badgeteam/hackerhotel2027-hardware/design/ai/all_tentacles_check.html

# all 5 tentacles — reconstructed LED chains

Re-extracted by detecting red pixels directly in a fresh high-resolution render of starfish_silkscreen.svg, instead of parsing path geometry — the previous pass mis-measured two circles on arm_right because your edit had merged some paths into multi-part shapes, which inflated their computed centers. Pixel detection sidesteps that.

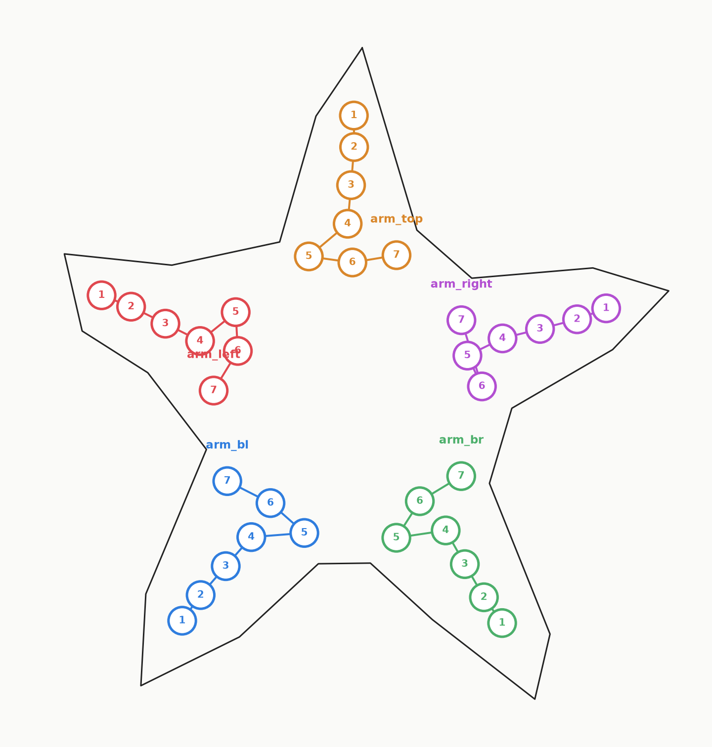
[picture p1: design/ai/all_tentacles_check.png]
Starfish outline with all 5 tentacle LED chains numbered tip to body


- arm_right (purple) — #1 and #3 now resolve correctly; the chain runs a clean 1→5 line down the arm instead of jumping around.
- arm_left, arm_br, arm_top — #5/#6 swapped as requested.
- arm_bl — re-confirmed against your original approval (this data source changed slightly, needed the same #5/#6 swap again).

If this looks right, next step is moving the matrix off-board and placing all 35 tentacle LEDs (plus rotating each to follow its local chain direction) via the IPC API.
