badgeteam/hackerhotel2027-hardware/design/ai/flank_leds_check.html

# 8 flanking 0402s per tentacle, RGB chain unmoved

For each of the 7 RGB positions, found the nearest small (unhighlighted) silkscreen dot to its left and right (perpendicular to the local chain direction), then kept the best 8 per arm — so coverage spreads across most of the 7 positions rather than clustering at one spot. All matches land within 8 mm of their RGB neighbor; most under 4 mm.

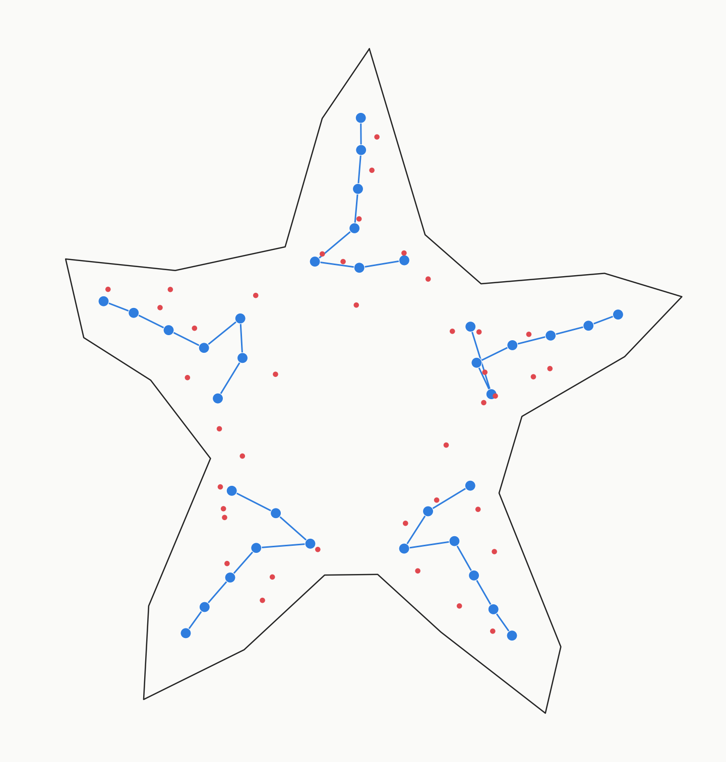
[picture p2: design/ai/flank_leds_check.png]
All 5 tentacles with the confirmed RGB LED chain in blue and 8 flanking single-color 0402 LEDs in red snapped to nearby silkscreen dots


RGB chain (unmoved) flanking 0402, snapped to an existing silkscreen dot

- Distribution isn't perfectly symmetric L/R or across all 7 positions — it follows wherever the existing artwork actually has a nearby dot, since the pattern itself isn't perfectly even arm-to-arm.
- arm_left leans mostly to one side (the artwork has fewer dots on its other side near the chain) — worth a glance if you want it more balanced.
- None of the 40 flank LEDs reuse a silkscreen dot already claimed by another flank or by the RGB chain.

If this looks right, next step is pushing all 40 (8×5) flank LEDs plus the 235-LED ring matrix to the live board via the IPC API, alongside the unmoved RGB tentacle chains.
