badgeteam/hackerhotel2027-hardware/design/ai/matrix_rings_check.html

# center matrix — dartboard spokes, 9 rings, 279 LEDs

Single LED at the center, then 9 rings at a constant 2.2 mm radial step. Spoke count starts at 6 and doubles whenever tangential spacing would otherwise exceed ≈1.4× the target pitch — each doubling reuses the existing spoke angles and interleaves new ones, so 6 spokes run perfectly straight from center to rim, with more forking in further out. Lands on 279 with only the outermost ring trimmed (48→44, ≈8%).

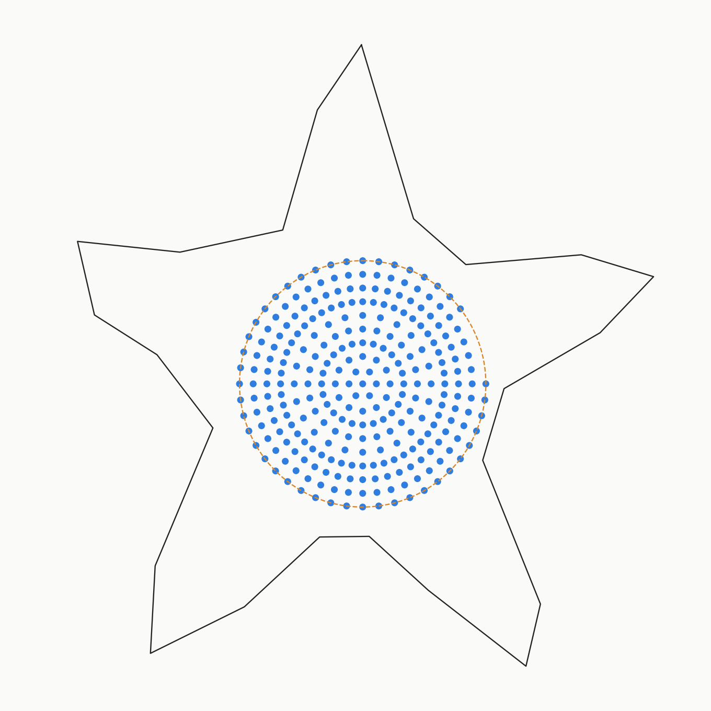
[picture p3: design/ai/matrix_rings_check.png]
Starfish outline with a dartboard-style spoke LED matrix filling the central cavity


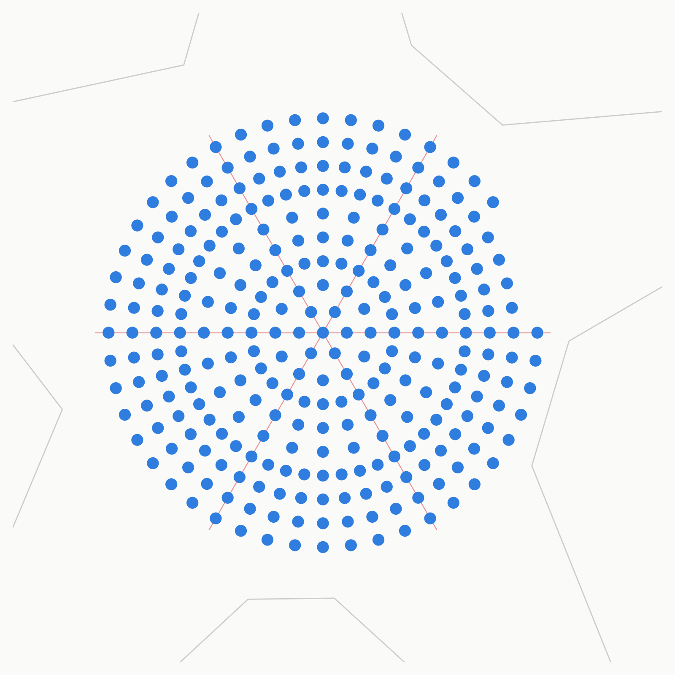
[picture p4: design/ai/spoke_zoom_check.png]
Zoomed view with the 6 primary spokes highlighted in red, confirming they run straight from center to edge through LED centers


Zoomed check: red lines are the 6 unbroken spokes, overlaid to confirm alignment — they pass exactly through LED centers at every ring.

ring | radius (mm) | spokes | arc pitch (mm)
center | 0 | 1 | —
1 | 2.2 | 6 | 2.304
2 | 4.4 | 12 | 2.304
3 | 6.6 | 24 | 1.728
4 | 8.8 | 24 | 2.304
5 | 11.0 | 24 | 2.880
6 | 13.2 | 48 | 1.728
7 | 15.4 | 48 | 2.016
8 | 17.6 | 48 | 2.304
9 | 19.8 | 44 (trimmed from 48) | 2.592

- 6 spokes run unbroken from center to rim; 6 more join at ring 3, 24 more at ring 6 — all stay radially aligned with the originals.
- Arc pitch ranges 1.73–2.88 mm — a bit less even than the pure-ring version, the tradeoff for spoke alignment.
- Four-layer board handles inner-ring trace escape through vias without issue.
- Scrolling text/graphics mapping (ring/spoke → pixel) is a firmware concern, happy to sanity-check once layout is settled.
