badgeteam/hackerhotel2027-hardware/design/ai/tentacle_check.html

# tentacle 1 — LED chain order, reconstructed from your markup

Matched each red mark to the nearest silkscreen dot by rendering the SVG's coordinate space and solving for the pixel→mm transform (residuals <0.2 mm on 6 of 7 points). Chain order below runs tip→body, inferred from vertical position in the image.

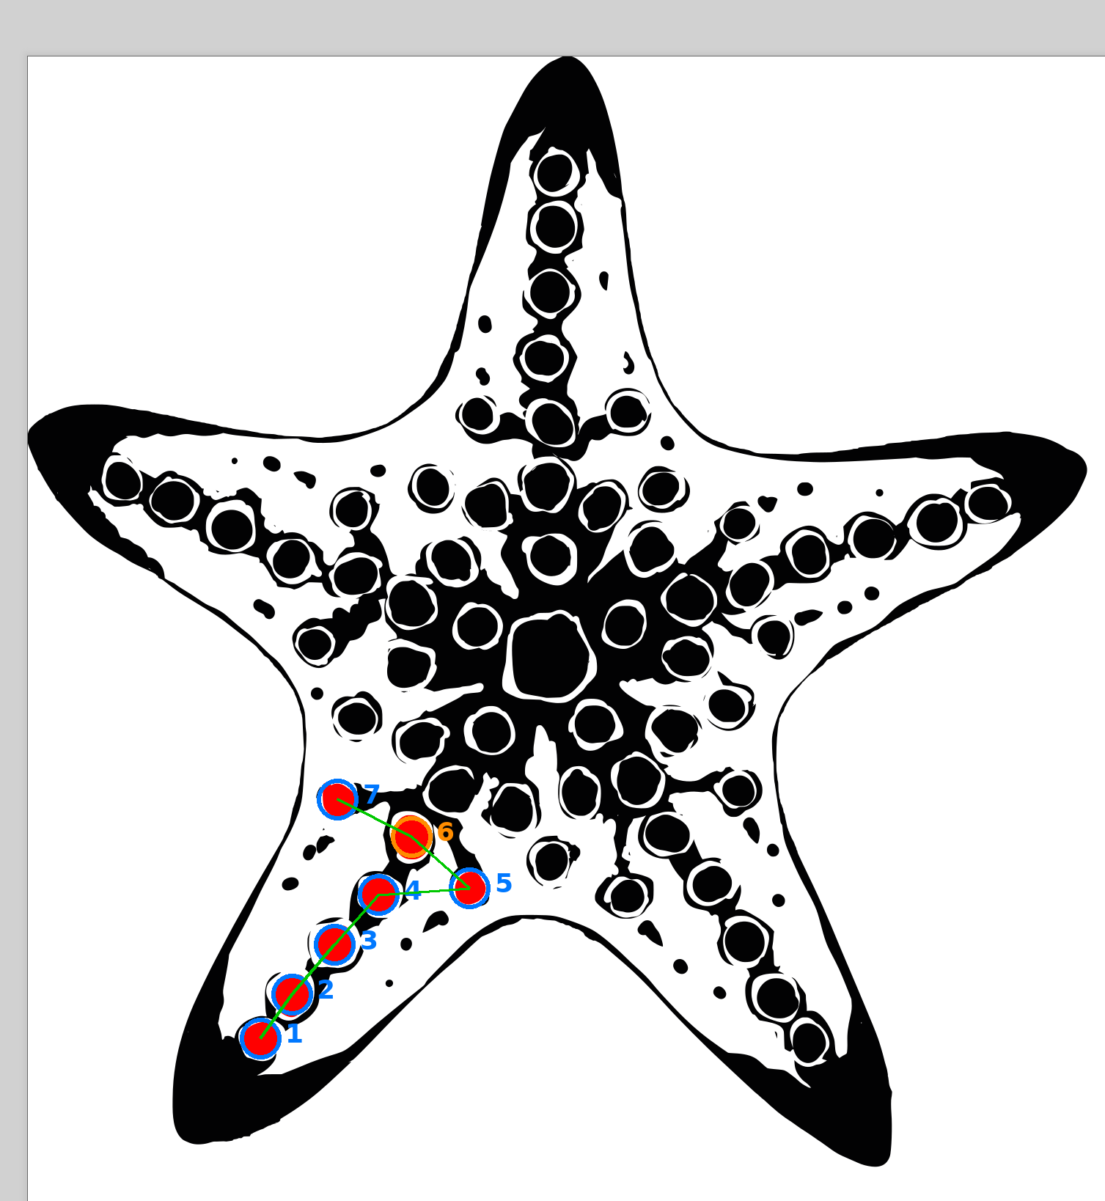
[picture p5: design/ai/tentacle_order_check.png]
Starfish silkscreen with red-highlighted tentacle LED positions, overlaid with numbered order markers


matched to an existing silkscreen dot no dot here — gap in the texture, position interpolated

# | x (mm) | y (mm) | source

1 | 79.05 | 242.64 | silkscreen dot
2 | 86.67 | 232.45 | silkscreen dot
3 | 96.70 | 220.56 | silkscreen dot
4 | 106.77 | 208.92 | silkscreen dot
5 | 128.28 | 207.26 | silkscreen dot
6 | 114.71 | 195.16 | no dot — interpolated
7 | 97.53 | 186.27 | silkscreen dot

Two things to confirm before I replicate this onto the other 4 arms: is tip→body (1→7) the order you want wired, and for #6, should the LED sit at the interpolated point shown, or snap to a nearby real dot instead?
