badgeteam/hackerhotel2027-hardware/design/ai/crop_arm_right.png

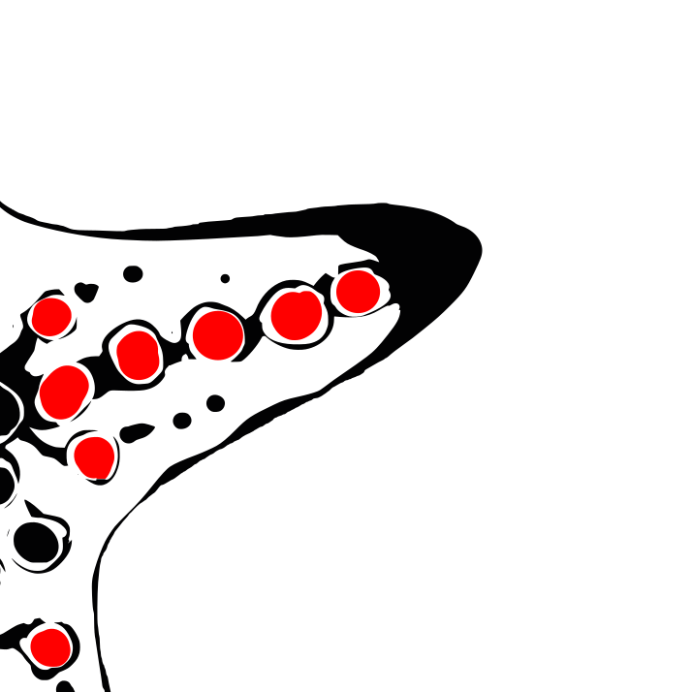
design/ai/crop_arm_right.png
