badgeteam/hackerhotel2027-hardware/design/ai/flow_matrix_check.png

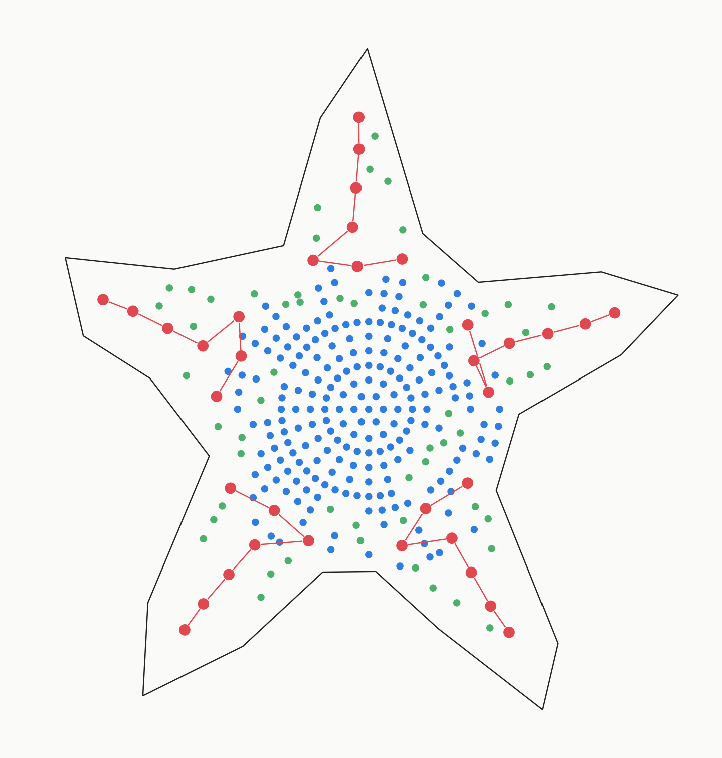
design/ai/flow_matrix_check.png
