badgeteam/hackerhotel2027-hardware/design/ai/grid_final_check.png

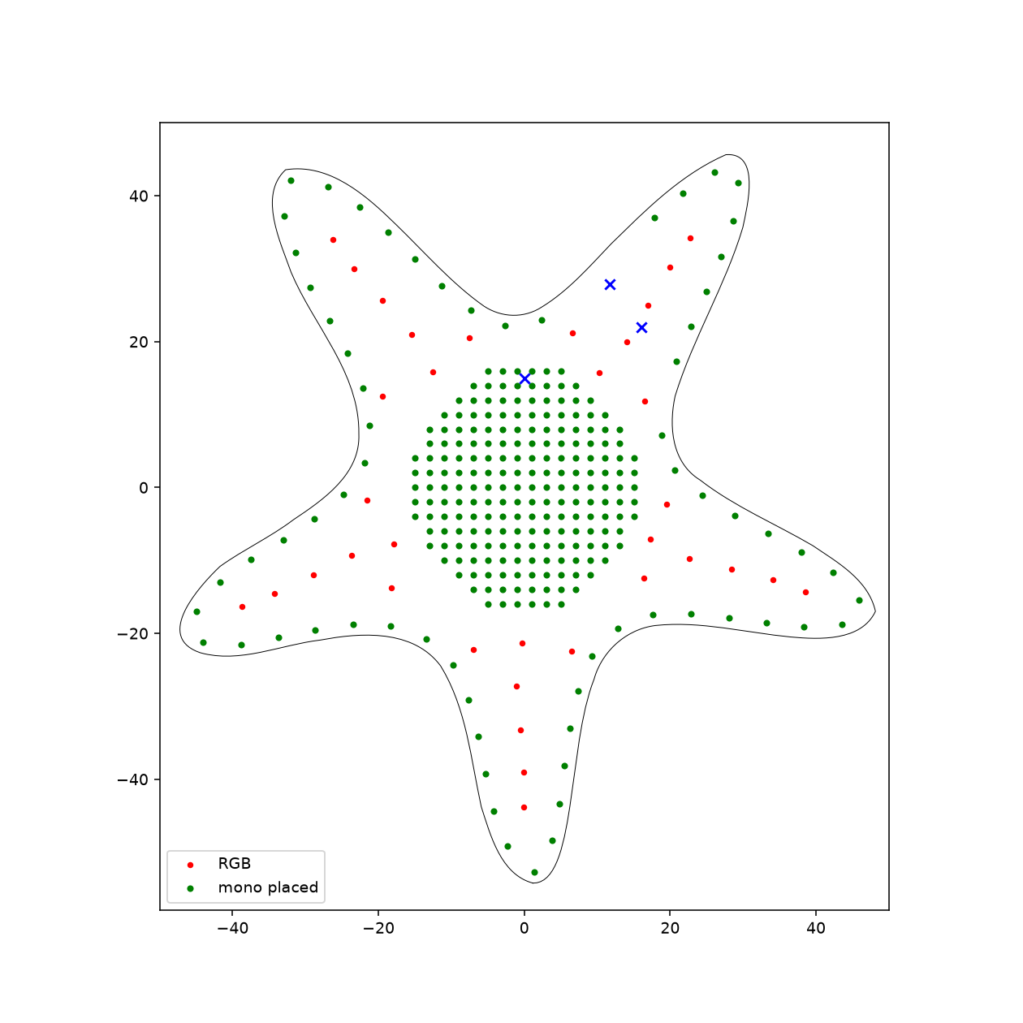
design/ai/grid_final_check.png
