badgeteam/hackerhotel2027-hardware/design/ai/grid_matrix_new_check.png

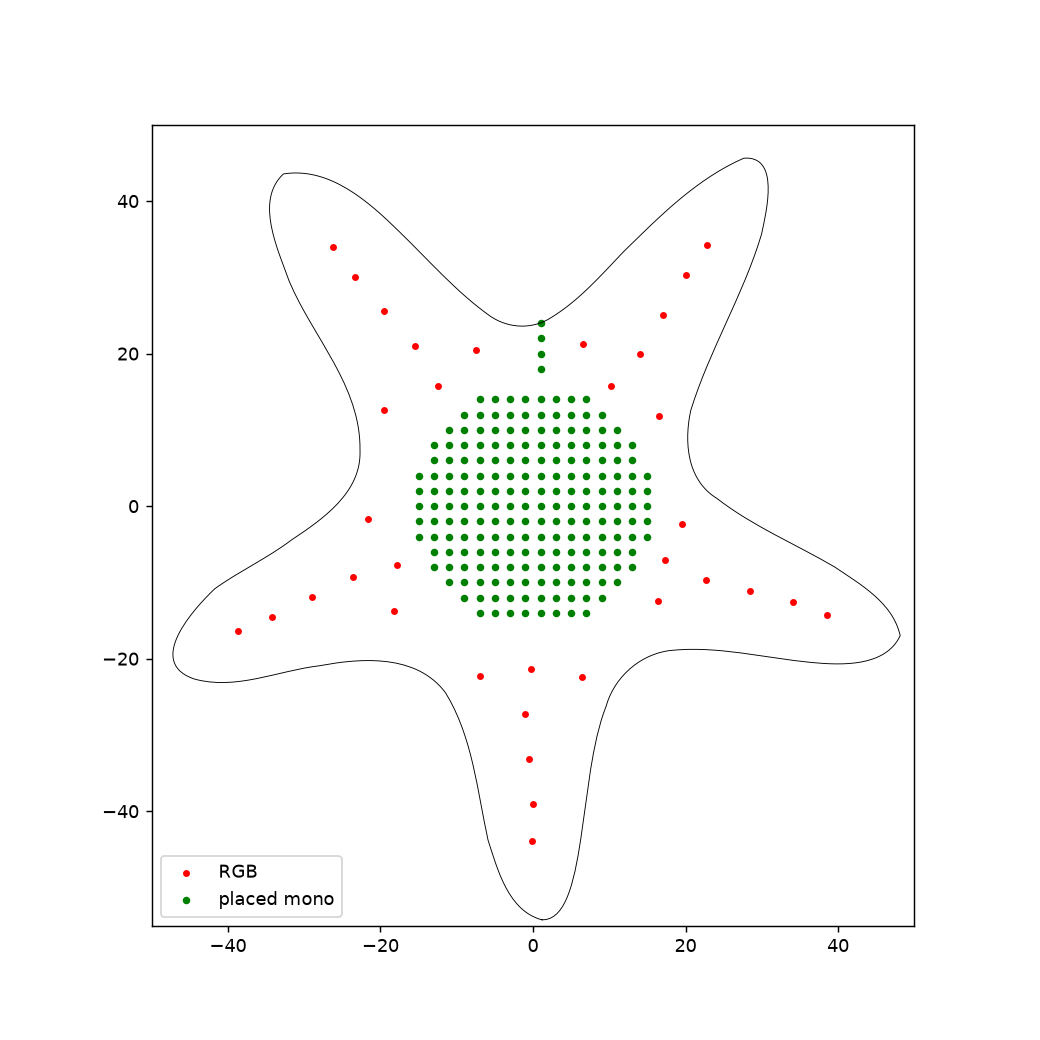
design/ai/grid_matrix_new_check.png
