badgeteam/hackerhotel2027-hardware/design/ai/silk_full.png

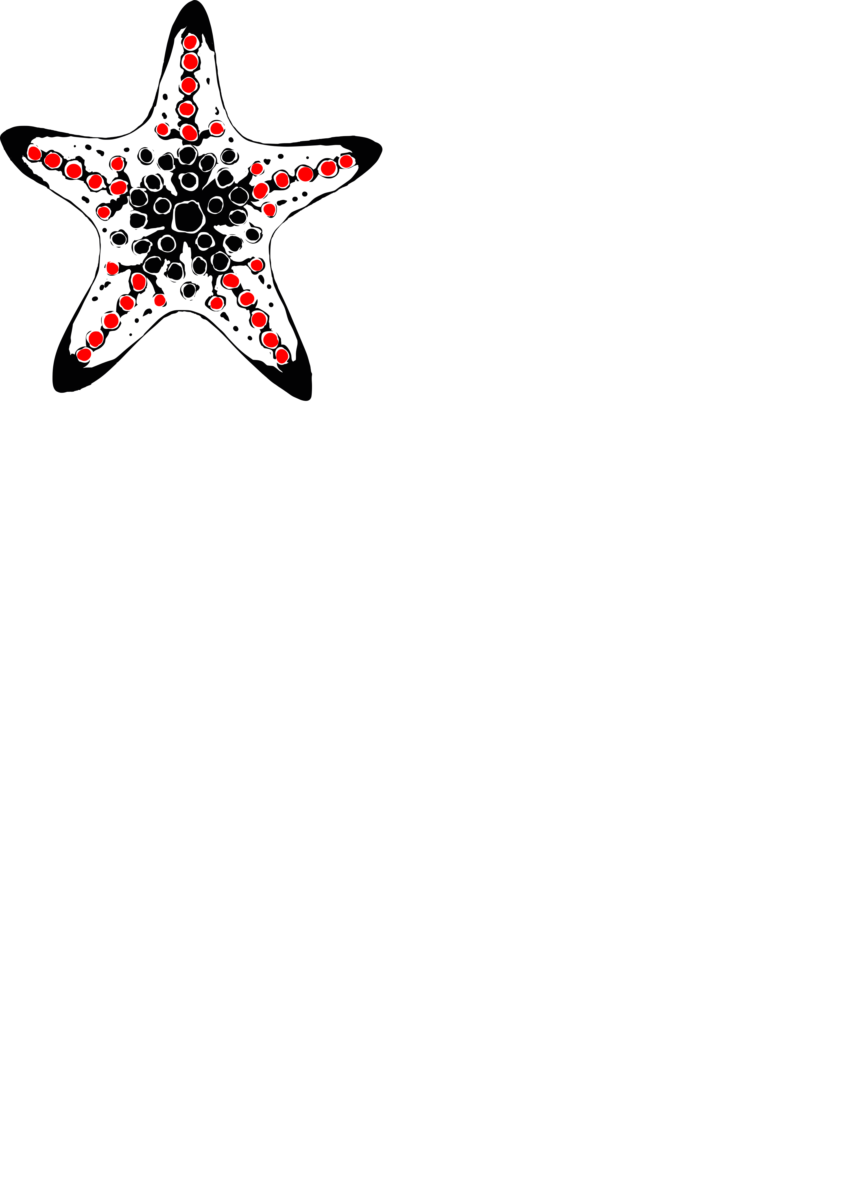
design/ai/silk_full.png
