badgeteam/hackerhotel2027-hardware/production/bom.csv

Designator | Footprint | Quantity | Value | LCSC Part #
C1, C3, C7 | 0603 | 3 | 10u | C19702
C2 | 0402 | 1 | 100n | C1525
C4, C5 | 0402 | 2 | 100n | C307331
C8 | 0603 | 1 | 1u | C5199872
D1, D10, D100, D101, D102, D103, D104, D105, D106, D107, D108, D109, D11, D110, D111, D112, D113, D114, D115, D116, D117, D118, D119, D12, D120, D121, D122, D123, D124, D125, D126, D127, D128, D129, D13, D130, D131, D132, D133, D134, D135, D136, D137, D138, D139, D14, D140, D141, D142, D143, D144, D145, D146, D147, D148, D149, D15, D150, D158, D159, D16, D160, D161, D162, D163, D164, D165, D166, D167, D168, D169, D17, D170, D171, D172, D173, D174, D175, D176, D177, D178, D179, D18, D180, D181, D182, D183, D184, D185, D186, D187, D188, D189, D19, D190, D191, D192, D193, D194, D195, D196, D197, D198, D199, D2, D20, D200, D201, D202, D203, D204, D205, D206, D207, D208, D21, D216, D217, D218, D219, D22, D220, D221, D222, D223, D224, D225, D226, D227, D228, D229, D23, D230, D231, D232, D233, D234, D235, D236, D237, D238, D239, D24, D240, D241, D242, D243, D244, D245, D246, D247, D248, D249, D25, D250, D251, D252, D253, D254, D255, D256, D257, D258, D259, D26, D260, D261, D262, D263, D264, D265, D266, D27, D274, D275, D276, D277, D278, D279, D28, D280, D281, D282, D283, D284, D285, D286, D287, D288, D289, D29, D290, D291, D292, D293, D294, D295, D296, D297, D298 | 0402 | 200 | LED | C52675968
D151, D152, D153, D154, D155, D156, D157, D209, D210, D211, D212, D213, D214, D215, D267, D268, D269, D270, D271, D272, D273, D35, D36, D37, D38, D39, D40, D41, D93, D94, D95, D96, D97, D98, D99 | LED-SMD-4P-L1.6-W1.5_NH-B1515RGBA-GF | 35 | NH-B1515RGBA-GF | C52212029
D299, D3, D30, D300, D301, D302, D303, D304, D305, D306, D307, D308, D309, D31, D310, D311, D312, D313, D314, D32, D33, D34, D4, D42, D43, D44, D45, D46, D47, D48, D49, D5, D50, D51, D52, D53, D54, D55, D56, D57, D58, D59, D6, D60, D61, D62, D63, D64, D65, D66, D67, D68, D69, D7, D70, D71, D72, D73, D74, D75, D76, D77, D78, D79, D8, D80, D81, D82, D83, D84, D85, D86, D87, D88, D89, D9, D90, D91, D92 | 0402 | 79 | LED | C52675968
D315 | 0603 | 1 | IR LED | C965886
D316 | D_SOD-323 | 1 | 1N5819WS | C191023
J1 | USB_C_Receptacle_HRO_TYPE-C-31-M-12 | 1 | USB device | C165948
J2 | CONN-SMD_PH-2AWB | 1 | Battery | C20598817
Q1 | SOT-23 | 1 | JSM2301S | C916399
R1, R10, R11, R12, R13, R14, R15, R16, R17, R18, R19, R2, R20, R21, R22, R23, R24, R3, R32, R4, R5, R6, R7, R8, R9 | 0402 | 25 | 200 | C25087
R25, R26, R27, R29, R30, R34, R36 | 0402 | 7 | 10k | C25744
R28 | 0402 | 1 | 47 | C22369545
R31, R33 | 0402 | 2 | 5k1 | C25905
R35 | 0402 | 1 | 2k | C4109
R37 | 0402 | 1 | 100k | C25741
S1 | OPTO-SMD_4P-L3.9-W3.4_IRM-H432M3-R8 | 1 | DY-IRMHF384-T05-2.5KB | C7280961
SW1, SW2, SW3, SW4 | SW-SMD_4P-L5.1-W5.1-P3.70-LS6.5-TL_H1.5 | 4 | TS-1187A-B-A-B | C318884
U1 | LQFP-64_L7.0-W7.0-P0.40-LS9.2-BL | 1 | CH643Q | C22448687
U2 | USON-10_L2.5-W1.0-P0.50-BL | 1 | TPD4E05U06DQAR | C138714
U3 | SOT-23-5 | 1 | XT4054K421MR-G | C141405
