badgeteam/hackerhotel2027-hardware/hackerhotel2027.kicad_pcb

## KiCad design hackerhotel2027.kicad_pcb (2026-10-26)

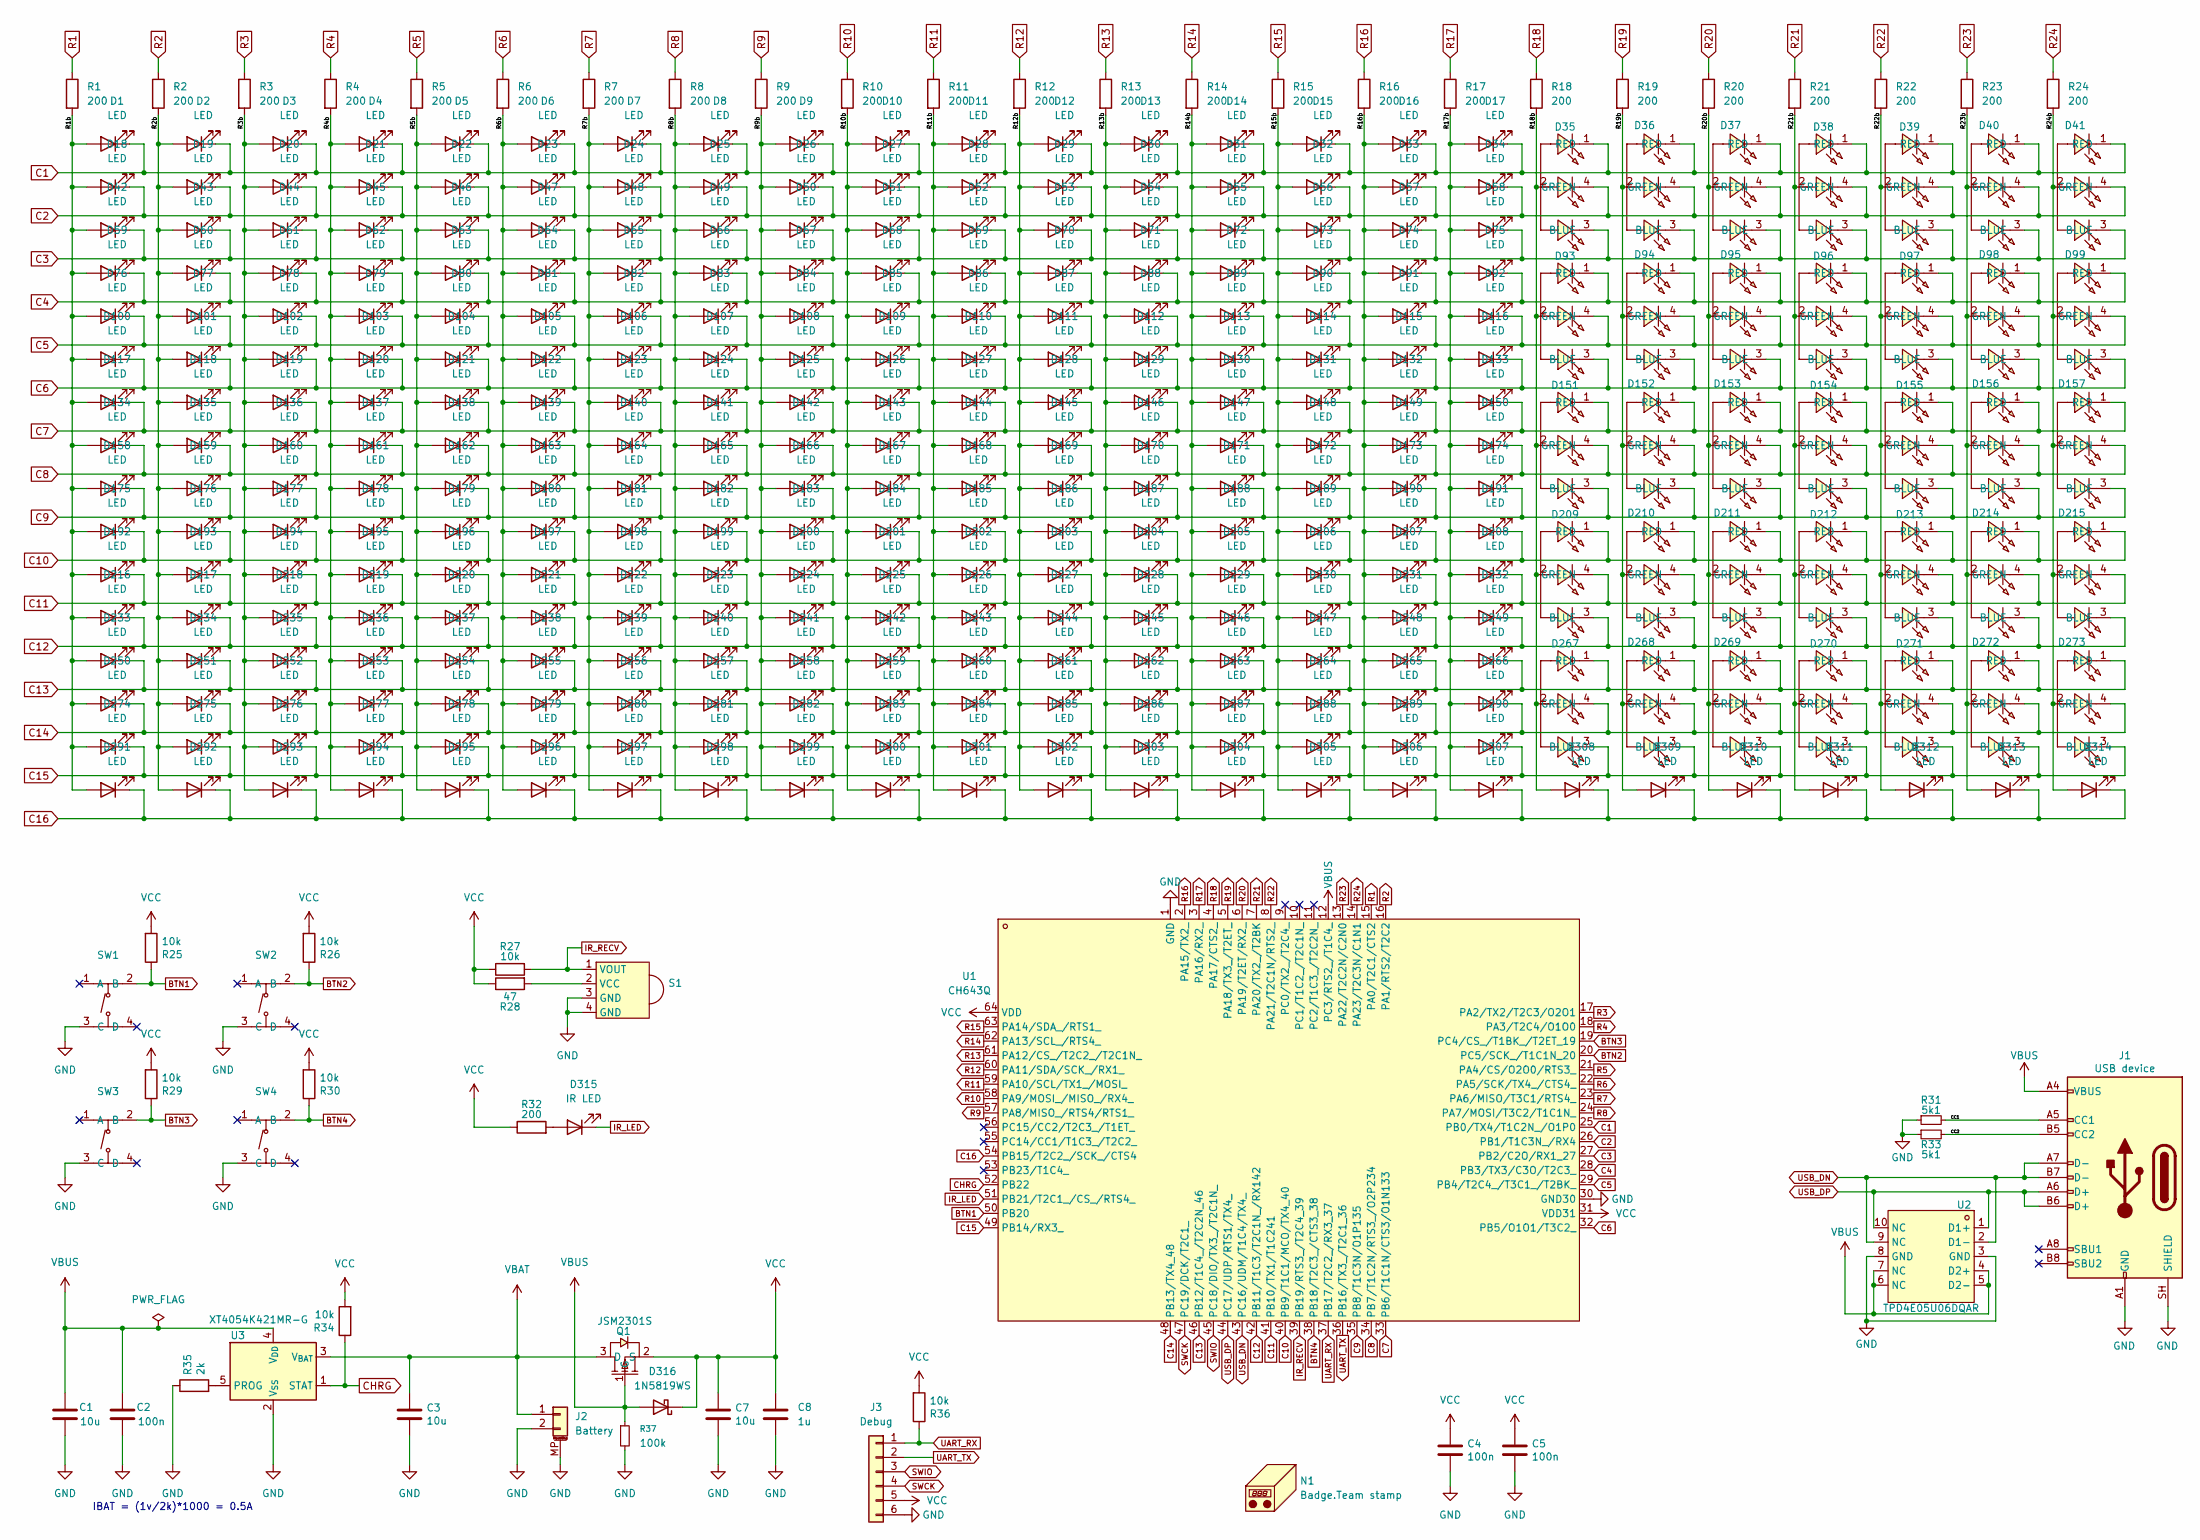
[picture p11: schematic hackerhotel2027.kicad_sch, Hackerhotel 2027 badge]

Parts:
C1, C3, C7: 10u; C_0603_1608Metric; LCSC Part C19702
C2: 100n; C_0402_1005Metric; LCSC Part C1525
C4, C5: 100n; C_0402_1005Metric; LCSC Part C307331
C8: 1u; C_0603_1608Metric; LCSC Part C5199872
D1, D2, D3, D4, D5, D6, D7, D8, D9, D10, D11, D12, D13, D14, D15, D16, D17, D18, D19, D20, D21, D22, D23, D24, D25, D26, D27, D28, D29, D30, D31, D32, D33, D34, D42, D43, D44, D45, D46, D47, D48, D49, D50, D51, D52, D53, D54, D55, D56, D57, D58, D59, D60, D61, D62, D63, D64, D65, D66, D67, D68, D69, D70, D71, D72, D73, D74, D75, D76, D77, D78, D79, D80, D81, D82, D83, D84, D85, D86, D87, D88, D89, D90, D91, D92, D100, D101, D102, D103, D104, D105, D106, D107, D108, D109, D110, D111, D112, D113, D114, D115, D116, D117, D118, D119, D120, D121, D122, D123, D124, D125, D126, D127, D128, D129, D130, D131, D132, D133, D134, D135, D136, D137, D138, D139, D140, D141, D142, D143, D144, D145, D146, D147, D148, D149, D150, D158, D159, D160, D161, D162, D163, D164, D165, D166, D167, D168, D169, D170, D171, D172, D173, D174, D175, D176, D177, D178, D179, D180, D181, D182, D183, D184, D185, D186, D187, D188, D189, D190, D191, D192, D193, D194, D195, D196, D197, D198, D199, D200, D201, D202, D203, D204, D205, D206, D207, D208, D216, D217, D218, D219, D220, D221, D222, D223, D224, D225, D226, D227, D228, D229, D230, D231, D232, D233, D234, D235, D236, D237, D238, D239, D240, D241, D242, D243, D244, D245, D246, D247, D248, D249, D250, D251, D252, D253, D254, D255, D256, D257, D258, D259, D260, D261, D262, D263, D264, D265, D266, D274, D275, D276, D277, D278, D279, D280, D281, D282, D283, D284, D285, D286, D287, D288, D289, D290, D291, D292, D293, D294, D295, D296, D297, D298, D299, D300, D301, D302, D303, D304, D305, D306, D307, D308, D309, D310, D311, D312, D313, D314: LED; LED_0402_1005Metric_nosilk; LCSC Part C52675968
D35, D36, D37, D38, D39, D40, D41, D93, D94, D95, D96, D97, D98, D99, D151, D152, D153, D154, D155, D156, D157, D209, D210, D211, D212, D213, D214, D215, D267, D268, D269, D270, D271, D272, D273: NH-B1515RGBA-GF; LED-SMD-4P-L1.6-W1.5_NH-B1515RGBA-GF; MPN NH-B1515RGBA-GF; LCSC Part C52212029
D315: IR LED; LED_0603_1608Metric; LCSC Part C965886
D316: 1N5819WS; D_SOD-323; LCSC Part C191023
J1: USB device; USB_C_Receptacle_HRO_TYPE-C-31-M-12; LCSC Part C165948
J2: Battery; CONN-SMD_PH-2AWB; LCSC Part C20598817
J3: Debug; PinHeader_1x06_P1.27mm_Vertical
N1: Badge.Team stamp; stamp_small
Q1: JSM2301S; SOT-23; LCSC Part C916399
R1, R2, R3, R4, R5, R6, R7, R8, R9, R10, R11, R12, R13, R14, R15, R16, R17, R18, R19, R20, R21, R22, R23, R24, R32: 200; R_0402_1005Metric; LCSC Part C25087
R25, R26, R27, R29, R30, R34, R36: 10k; R_0402_1005Metric; LCSC Part C25744
R28: 47; R_0402_1005Metric; LCSC Part C22369545
R31, R33: 5k1; R_0402_1005Metric; LCSC Part C25905
R35: 2k; R_0402_1005Metric; LCSC Part C4109
R37: 100k; R_0402_1005Metric; LCSC Part C25741
S1: DY-IRMHF384-T05-2.5KB; OPTO-SMD_4P-L3.9-W3.4_IRM-H432M3-R8; MPN DY-IRMHF384-T05-2.5KB; LCSC Part C7280961
SW1, SW2, SW3, SW4: TS-1187A-B-A-B; SW-SMD_4P-L5.1-W5.1-P3.70-LS6.5-TL_H1.5; MPN TS-1187A-B-A-B; LCSC Part C318884
U1: CH643Q; LQFP-64_L7.0-W7.0-P0.40-LS9.2-BL; MPN CH643Q; LCSC Part C22448687
U2: TPD4E05U06DQAR; USON-10_L2.5-W1.0-P0.50-BL; LCSC Part C138714
U3: XT4054K421MR-G; SOT-23-5; LCSC Part C141405

Connections:
/CC1: J1.A5 (CC1), R31.2
/CC2: J1.B5 (CC2), R33.2
/R1b: D1.2 (A), D18.2 (A), D42.2 (A), D59.2 (A), D76.2 (A), D100.2 (A), D117.2 (A), D134.2 (A), D158.2 (A), D175.2 (A), D192.2 (A), D216.2 (A), D233.2 (A), D250.2 (A), D274.2 (A), D291.2 (A), R1.2
/R2b: D2.2 (A), D19.2 (A), D43.2 (A), D60.2 (A), D77.2 (A), D101.2 (A), D118.2 (A), D135.2 (A), D159.2 (A), D176.2 (A), D193.2 (A), D217.2 (A), D234.2 (A), D251.2 (A), D275.2 (A), D292.2 (A), R2.2
/R3b: D3.2 (A), D20.2 (A), D44.2 (A), D61.2 (A), D78.2 (A), D102.2 (A), D119.2 (A), D136.2 (A), D160.2 (A), D177.2 (A), D194.2 (A), D218.2 (A), D235.2 (A), D252.2 (A), D276.2 (A), D293.2 (A), R3.2
/R4b: D4.2 (A), D21.2 (A), D45.2 (A), D62.2 (A), D79.2 (A), D103.2 (A), D120.2 (A), D137.2 (A), D161.2 (A), D178.2 (A), D195.2 (A), D219.2 (A), D236.2 (A), D253.2 (A), D277.2 (A), D294.2 (A), R4.2
/R5b: D5.2 (A), D22.2 (A), D46.2 (A), D63.2 (A), D80.2 (A), D104.2 (A), D121.2 (A), D138.2 (A), D162.2 (A), D179.2 (A), D196.2 (A), D220.2 (A), D237.2 (A), D254.2 (A), D278.2 (A), D295.2 (A), R5.2
/R6b: D6.2 (A), D23.2 (A), D47.2 (A), D64.2 (A), D81.2 (A), D105.2 (A), D122.2 (A), D139.2 (A), D163.2 (A), D180.2 (A), D197.2 (A), D221.2 (A), D238.2 (A), D255.2 (A), D279.2 (A), D296.2 (A), R6.2
/R7b: D7.2 (A), D24.2 (A), D48.2 (A), D65.2 (A), D82.2 (A), D106.2 (A), D123.2 (A), D140.2 (A), D164.2 (A), D181.2 (A), D198.2 (A), D222.2 (A), D239.2 (A), D256.2 (A), D280.2 (A), D297.2 (A), R7.2
/R8b: D8.2 (A), D25.2 (A), D49.2 (A), D66.2 (A), D83.2 (A), D107.2 (A), D124.2 (A), D141.2 (A), D165.2 (A), D182.2 (A), D199.2 (A), D223.2 (A), D240.2 (A), D257.2 (A), D281.2 (A), D298.2 (A), R8.2
/R9b: D9.2 (A), D26.2 (A), D50.2 (A), D67.2 (A), D84.2 (A), D108.2 (A), D125.2 (A), D142.2 (A), D166.2 (A), D183.2 (A), D200.2 (A), D224.2 (A), D241.2 (A), D258.2 (A), D282.2 (A), D299.2 (A), R9.2
/R10b: D10.2 (A), D27.2 (A), D51.2 (A), D68.2 (A), D85.2 (A), D109.2 (A), D126.2 (A), D143.2 (A), D167.2 (A), D184.2 (A), D201.2 (A), D225.2 (A), D242.2 (A), D259.2 (A), D283.2 (A), D300.2 (A), R10.2
/R11b: D11.2 (A), D28.2 (A), D52.2 (A), D69.2 (A), D86.2 (A), D110.2 (A), D127.2 (A), D144.2 (A), D168.2 (A), D185.2 (A), D202.2 (A), D226.2 (A), D243.2 (A), D260.2 (A), D284.2 (A), D301.2 (A), R11.2
/R12b: D12.2 (A), D29.2 (A), D53.2 (A), D70.2 (A), D87.2 (A), D111.2 (A), D128.2 (A), D145.2 (A), D169.2 (A), D186.2 (A), D203.2 (A), D227.2 (A), D244.2 (A), D261.2 (A), D285.2 (A), D302.2 (A), R12.2
/R13b: D13.2 (A), D30.2 (A), D54.2 (A), D71.2 (A), D88.2 (A), D112.2 (A), D129.2 (A), D146.2 (A), D170.2 (A), D187.2 (A), D204.2 (A), D228.2 (A), D245.2 (A), D262.2 (A), D286.2 (A), D303.2 (A), R13.2
/R14b: D14.2 (A), D31.2 (A), D55.2 (A), D72.2 (A), D89.2 (A), D113.2 (A), D130.2 (A), D147.2 (A), D171.2 (A), D188.2 (A), D205.2 (A), D229.2 (A), D246.2 (A), D263.2 (A), D287.2 (A), D304.2 (A), R14.2
/R15b: D15.2 (A), D32.2 (A), D56.2 (A), D73.2 (A), D90.2 (A), D114.2 (A), D131.2 (A), D148.2 (A), D172.2 (A), D189.2 (A), D206.2 (A), D230.2 (A), D247.2 (A), D264.2 (A), D288.2 (A), D305.2 (A), R15.2
/R16b: D16.2 (A), D33.2 (A), D57.2 (A), D74.2 (A), D91.2 (A), D115.2 (A), D132.2 (A), D149.2 (A), D173.2 (A), D190.2 (A), D207.2 (A), D231.2 (A), D248.2 (A), D265.2 (A), D289.2 (A), D306.2 (A), R16.2
/R17b: D17.2 (A), D34.2 (A), D58.2 (A), D75.2 (A), D92.2 (A), D116.2 (A), D133.2 (A), D150.2 (A), D174.2 (A), D191.2 (A), D208.2 (A), D232.2 (A), D249.2 (A), D266.2 (A), D290.2 (A), D307.2 (A), R17.2
/R18b: D35.2, D93.2, D151.2, D209.2, D267.2, D308.2 (A), R18.2
/R19b: D36.2, D94.2, D152.2, D210.2, D268.2, D309.2 (A), R19.2
/R20b: D37.2, D95.2, D153.2, D211.2, D269.2, D310.2 (A), R20.2
/R21b: D38.2, D96.2, D154.2, D212.2, D270.2, D311.2 (A), R21.2
/R22b: D39.2, D97.2, D155.2, D213.2, D271.2, D312.2 (A), R22.2
/R23b: D40.2, D98.2, D156.2, D214.2, D272.2, D313.2 (A), R23.2
/R24b: D41.2, D99.2, D157.2, D215.2, D273.2, D314.2 (A), R24.2
BTN1: R25.1, SW1.2 (B), U1.50 (PB20)
BTN2: R26.1, SW2.2 (B), U1.20 (PC5/SCK_/T1C1N_20)
BTN3: R29.1, SW3.2 (B), U1.19 (PC4/CS_/T1BK_/T2ET_19)
BTN4: R30.1, SW4.2 (B), U1.38 (PB18/T2C3_/CTS3_38)
C1: D1.1 (K), D2.1 (K), D3.1 (K), D4.1 (K), D5.1 (K), D6.1 (K), D7.1 (K), D8.1 (K), D9.1 (K), D10.1 (K), D11.1 (K), D12.1 (K), D13.1 (K), D14.1 (K), D15.1 (K), D16.1 (K), D17.1 (K), D35.1 (RED), D36.1 (RED), D37.1 (RED), D38.1 (RED), D39.1 (RED), D40.1 (RED), D41.1 (RED), U1.25 (PB0/TX4/T1C2N_/O1P0)
C2: D18.1 (K), D19.1 (K), D20.1 (K), D21.1 (K), D22.1 (K), D23.1 (K), D24.1 (K), D25.1 (K), D26.1 (K), D27.1 (K), D28.1 (K), D29.1 (K), D30.1 (K), D31.1 (K), D32.1 (K), D33.1 (K), D34.1 (K), D35.4 (GREEN), D36.4 (GREEN), D37.4 (GREEN), D38.4 (GREEN), D39.4 (GREEN), D40.4 (GREEN), D41.4 (GREEN), U1.26 (PB1/T1C3N_/RX4)
C3: D35.3 (BLUE), D36.3 (BLUE), D37.3 (BLUE), D38.3 (BLUE), D39.3 (BLUE), D40.3 (BLUE), D41.3 (BLUE), D42.1 (K), D43.1 (K), D44.1 (K), D45.1 (K), D46.1 (K), D47.1 (K), D48.1 (K), D49.1 (K), D50.1 (K), D51.1 (K), D52.1 (K), D53.1 (K), D54.1 (K), D55.1 (K), D56.1 (K), D57.1 (K), D58.1 (K), U1.27 (PB2/C2O/RX1_27)
C4: D59.1 (K), D60.1 (K), D61.1 (K), D62.1 (K), D63.1 (K), D64.1 (K), D65.1 (K), D66.1 (K), D67.1 (K), D68.1 (K), D69.1 (K), D70.1 (K), D71.1 (K), D72.1 (K), D73.1 (K), D74.1 (K), D75.1 (K), D93.1 (RED), D94.1 (RED), D95.1 (RED), D96.1 (RED), D97.1 (RED), D98.1 (RED), D99.1 (RED), U1.28 (PB3/TX3/C3O/T2C3_)
C5: D76.1 (K), D77.1 (K), D78.1 (K), D79.1 (K), D80.1 (K), D81.1 (K), D82.1 (K), D83.1 (K), D84.1 (K), D85.1 (K), D86.1 (K), D87.1 (K), D88.1 (K), D89.1 (K), D90.1 (K), D91.1 (K), D92.1 (K), D93.4 (GREEN), D94.4 (GREEN), D95.4 (GREEN), D96.4 (GREEN), D97.4 (GREEN), D98.4 (GREEN), D99.4 (GREEN), U1.29 (PB4/T2C4_/T3C1_/T2BK_)
C6: D93.3 (BLUE), D94.3 (BLUE), D95.3 (BLUE), D96.3 (BLUE), D97.3 (BLUE), D98.3 (BLUE), D99.3 (BLUE), D100.1 (K), D101.1 (K), D102.1 (K), D103.1 (K), D104.1 (K), D105.1 (K), D106.1 (K), D107.1 (K), D108.1 (K), D109.1 (K), D110.1 (K), D111.1 (K), D112.1 (K), D113.1 (K), D114.1 (K), D115.1 (K), D116.1 (K), U1.32 (PB5/O1O1/T3C2_)
C7: D117.1 (K), D118.1 (K), D119.1 (K), D120.1 (K), D121.1 (K), D122.1 (K), D123.1 (K), D124.1 (K), D125.1 (K), D126.1 (K), D127.1 (K), D128.1 (K), D129.1 (K), D130.1 (K), D131.1 (K), D132.1 (K), D133.1 (K), D151.1 (RED), D152.1 (RED), D153.1 (RED), D154.1 (RED), D155.1 (RED), D156.1 (RED), D157.1 (RED), U1.33 (PB6/T1C1N/CTS3/O1N133)
C8: D134.1 (K), D135.1 (K), D136.1 (K), D137.1 (K), D138.1 (K), D139.1 (K), D140.1 (K), D141.1 (K), D142.1 (K), D143.1 (K), D144.1 (K), D145.1 (K), D146.1 (K), D147.1 (K), D148.1 (K), D149.1 (K), D150.1 (K), D151.4 (GREEN), D152.4 (GREEN), D153.4 (GREEN), D154.4 (GREEN), D155.4 (GREEN), D156.4 (GREEN), D157.4 (GREEN), U1.34 (PB7/T1C2N/RTS3_/O2P234)
C9: D151.3 (BLUE), D152.3 (BLUE), D153.3 (BLUE), D154.3 (BLUE), D155.3 (BLUE), D156.3 (BLUE), D157.3 (BLUE), D158.1 (K), D159.1 (K), D160.1 (K), D161.1 (K), D162.1 (K), D163.1 (K), D164.1 (K), D165.1 (K), D166.1 (K), D167.1 (K), D168.1 (K), D169.1 (K), D170.1 (K), D171.1 (K), D172.1 (K), D173.1 (K), D174.1 (K), U1.35 (PB8/T1C3N/O1P135)
C10: D175.1 (K), D176.1 (K), D177.1 (K), D178.1 (K), D179.1 (K), D180.1 (K), D181.1 (K), D182.1 (K), D183.1 (K), D184.1 (K), D185.1 (K), D186.1 (K), D187.1 (K), D188.1 (K), D189.1 (K), D190.1 (K), D191.1 (K), D209.1 (RED), D210.1 (RED), D211.1 (RED), D212.1 (RED), D213.1 (RED), D214.1 (RED), D215.1 (RED), U1.40 (PB9/T1C1/MCO/TX4_40)
C11: D192.1 (K), D193.1 (K), D194.1 (K), D195.1 (K), D196.1 (K), D197.1 (K), D198.1 (K), D199.1 (K), D200.1 (K), D201.1 (K), D202.1 (K), D203.1 (K), D204.1 (K), D205.1 (K), D206.1 (K), D207.1 (K), D208.1 (K), D209.4 (GREEN), D210.4 (GREEN), D211.4 (GREEN), D212.4 (GREEN), D213.4 (GREEN), D214.4 (GREEN), D215.4 (GREEN), U1.41 (PB10/TX1/T1C241)
C12: D209.3 (BLUE), D210.3 (BLUE), D211.3 (BLUE), D212.3 (BLUE), D213.3 (BLUE), D214.3 (BLUE), D215.3 (BLUE), D216.1 (K), D217.1 (K), D218.1 (K), D219.1 (K), D220.1 (K), D221.1 (K), D222.1 (K), D223.1 (K), D224.1 (K), D225.1 (K), D226.1 (K), D227.1 (K), D228.1 (K), D229.1 (K), D230.1 (K), D231.1 (K), D232.1 (K), U1.42 (PB11/T1C3/T2C1N_/RX142)
C13: D233.1 (K), D234.1 (K), D235.1 (K), D236.1 (K), D237.1 (K), D238.1 (K), D239.1 (K), D240.1 (K), D241.1 (K), D242.1 (K), D243.1 (K), D244.1 (K), D245.1 (K), D246.1 (K), D247.1 (K), D248.1 (K), D249.1 (K), D267.1 (RED), D268.1 (RED), D269.1 (RED), D270.1 (RED), D271.1 (RED), D272.1 (RED), D273.1 (RED), U1.46 (PB12/T1C4_/T2C2N_46)
C14: D250.1 (K), D251.1 (K), D252.1 (K), D253.1 (K), D254.1 (K), D255.1 (K), D256.1 (K), D257.1 (K), D258.1 (K), D259.1 (K), D260.1 (K), D261.1 (K), D262.1 (K), D263.1 (K), D264.1 (K), D265.1 (K), D266.1 (K), D267.4 (GREEN), D268.4 (GREEN), D269.4 (GREEN), D270.4 (GREEN), D271.4 (GREEN), D272.4 (GREEN), D273.4 (GREEN), U1.48 (PB13/TX4_48)
C15: D267.3 (BLUE), D268.3 (BLUE), D269.3 (BLUE), D270.3 (BLUE), D271.3 (BLUE), D272.3 (BLUE), D273.3 (BLUE), D274.1 (K), D275.1 (K), D276.1 (K), D277.1 (K), D278.1 (K), D279.1 (K), D280.1 (K), D281.1 (K), D282.1 (K), D283.1 (K), D284.1 (K), D285.1 (K), D286.1 (K), D287.1 (K), D288.1 (K), D289.1 (K), D290.1 (K), U1.49 (PB14/RX3_)
C16: D291.1 (K), D292.1 (K), D293.1 (K), D294.1 (K), D295.1 (K), D296.1 (K), D297.1 (K), D298.1 (K), D299.1 (K), D300.1 (K), D301.1 (K), D302.1 (K), D303.1 (K), D304.1 (K), D305.1 (K), D306.1 (K), D307.1 (K), D308.1 (K), D309.1 (K), D310.1 (K), D311.1 (K), D312.1 (K), D313.1 (K), D314.1 (K), U1.54 (PB15/T2C2_/SCK_/CTS4)
CHRG: R34.1, U1.52 (PB22), U3.1 (STAT)
GND: C1.1, C2.1, C3.2, C4.2, C5.2, C7.2, C8.2, J1.A1 (GND), J1.A12 (GND), J1.B1 (GND), J1.B12 (GND), J1.SH (SHIELD), J2.2, J2.MP (MountPin), J3.6, R31.1, R33.1, R35.1, R37.2, S1.3 (GND), S1.4 (GND), SW1.3 (C), SW2.3 (C), SW3.3 (C), SW4.3 (C), U1.1 (GND), U1.30 (GND30), U2.3 (GND), U2.8 (GND), U3.2 (V_{SS})
IR_LED: D315.1 (K), U1.51 (PB21/T2C1_/CS_/RTS4_)
IR_RECV: R27.2, S1.1 (VOUT), U1.39 (PB19/RTS3_/T2C4_39)
unnamed: D315.2 (A), R32.2
unnamed: R28.2, S1.2 (VCC)
unnamed: R35.2, U3.5 (PROG)
R1: R1.1, U1.15 (PA0/T2C1/CTS2)
R2: R2.1, U1.16 (PA1/RTS2/T2C2)
R3: R3.1, U1.17 (PA2/TX2/T2C3/O2O1)
R4: R4.1, U1.18 (PA3/T2C4/O1O0)
R5: R5.1, U1.21 (PA4/CS/O2O0/RTS3_)
R6: R6.1, U1.22 (PA5/SCK/TX4_/CTS4_)
R7: R7.1, U1.23 (PA6/MISO/T3C1/RTS4_)
R8: R8.1, U1.24 (PA7/MOSI/T3C2/T1C1N_)
R9: R9.1, U1.57 (PA8/MISO_/RTS4/RTS1_)
R10: R10.1, U1.58 (PA9/MOSI_/MISO_/RX4_)
R11: R11.1, U1.59 (PA10/SCL/TX1_/MOSI_)
R12: R12.1, U1.60 (PA11/SDA/SCK_/RX1_)
R13: R13.1, U1.61 (PA12/CS_/T2C2_/T2C1N_)
R14: R14.1, U1.62 (PA13/SCL_/RTS4_)
R15: R15.1, U1.63 (PA14/SDA_/RTS1_)
R16: R16.1, U1.2 (PA15/TX2_)
R17: R17.1, U1.3 (PA16/RX2_)
R18: R18.1, U1.4 (PA17/CTS2_)
R19: R19.1, U1.5 (PA18/TX3_/T2ET_)
R20: R20.1, U1.6 (PA19/T2ET/RX2_)
R21: R21.1, U1.7 (PA20/TX2_/T2BK)
R22: R22.1, U1.8 (PA21/T2C1N/RTS2_)
R23: R23.1, U1.13 (PA22/T2C2N/C2N0)
R24: R24.1, U1.14 (PA23/T2C3N/C1N1)
SWCK: J3.4, U1.47 (PC19/DCK/T2C1_)
SWIO: J3.3, U1.45 (PC18/DIO/TX3_/T2C1N_)
UART_RX: J3.1, R36.1, U1.37 (PB17/T2C2_/RX3_37)
UART_TX: J3.2, U1.36 (PB16/TX3_/T2C1_36)
USB_DN: J1.A7 (D-), J1.B7 (D-), U1.43 (PC16/UDM/T1C4/TX4_), U2.2 (D1-), U2.9 (NC)
USB_DP: J1.A6 (D+), J1.B6 (D+), U1.44 (PC17/UDP/RTS1/TX4_), U2.1 (D1+), U2.10 (NC)
VBAT: C3.1, J2.1, Q1.3 (D), U3.3 (V_{BAT})
VBUS: C1.2, C2.2, D316.2 (A), J1.A4 (VBUS), J1.A9 (VBUS), J1.B4 (VBUS), J1.B9 (VBUS), Q1.1 (G), R37.1, U1.12 (PC3/RTS2_/T1C4_), U2.4 (D2+), U2.5 (D2-), U2.6 (NC), U2.7 (NC), U3.4 (V_{DD})
VCC: C4.1, C5.1, C7.1, C8.1, D316.1 (K), J3.5, Q1.2 (S), R25.2, R26.2, R27.1, R28.1, R29.2, R30.2, R32.1, R34.2, R36.2, U1.31 (VDD31), U1.64 (VDD)

Notes on the sheet:
IBAT = (1v/2k)*1000 = 0.5A

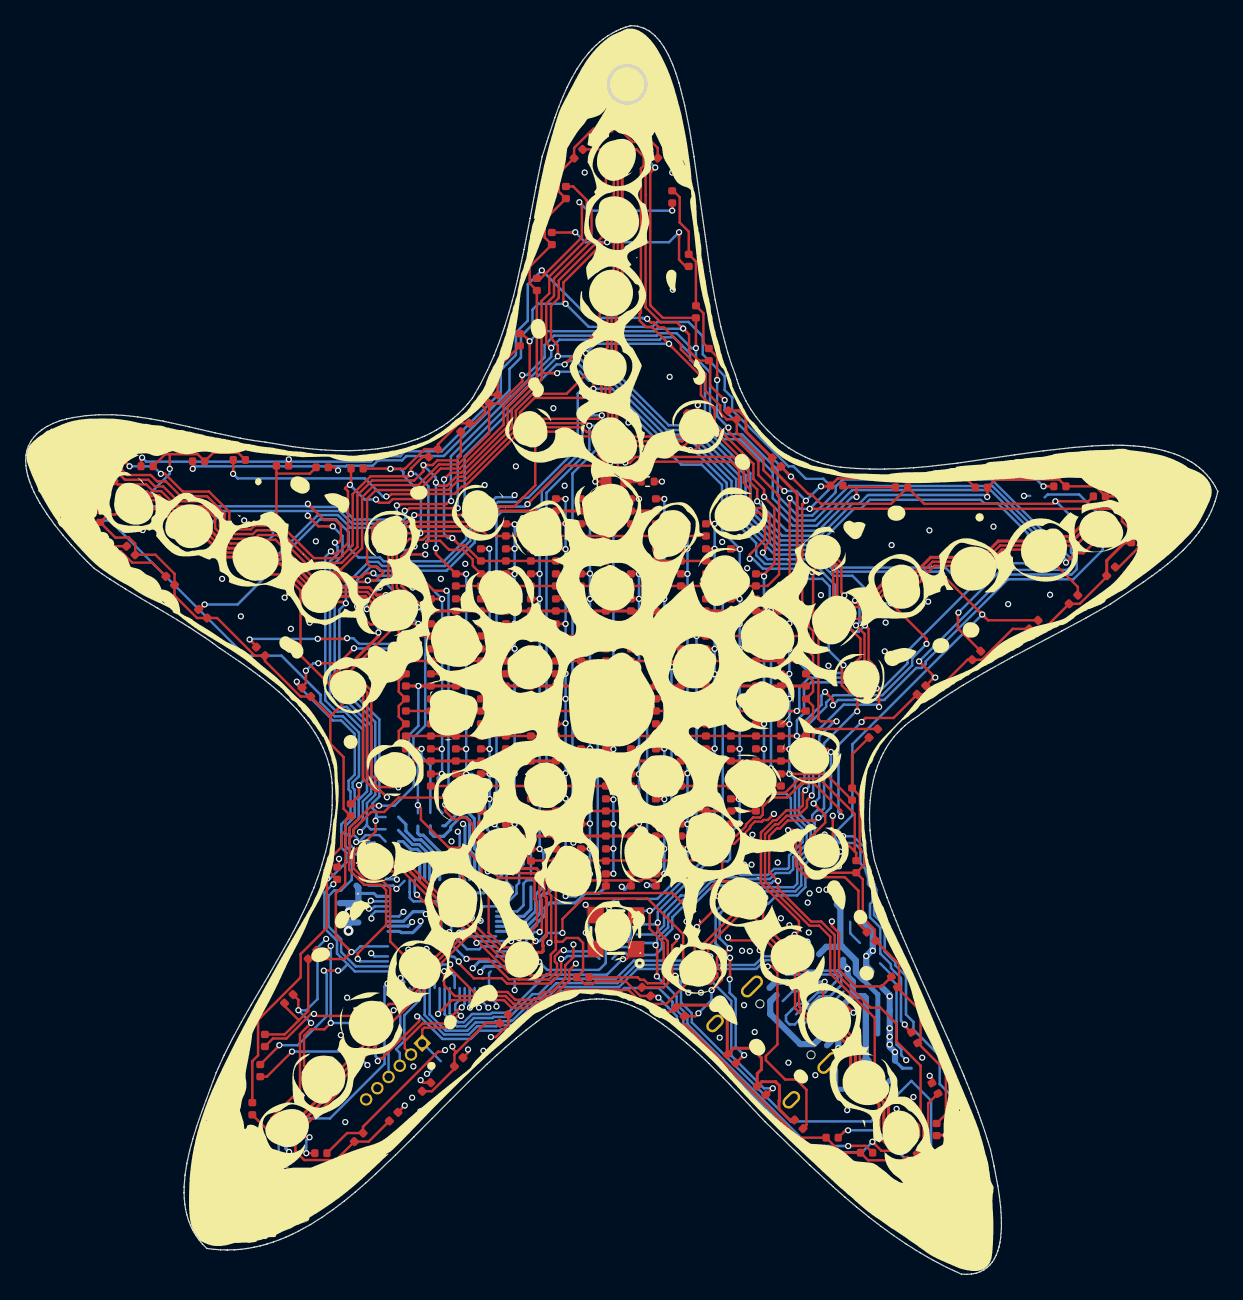
[picture p12: board hackerhotel2027.kicad_pcb from above]

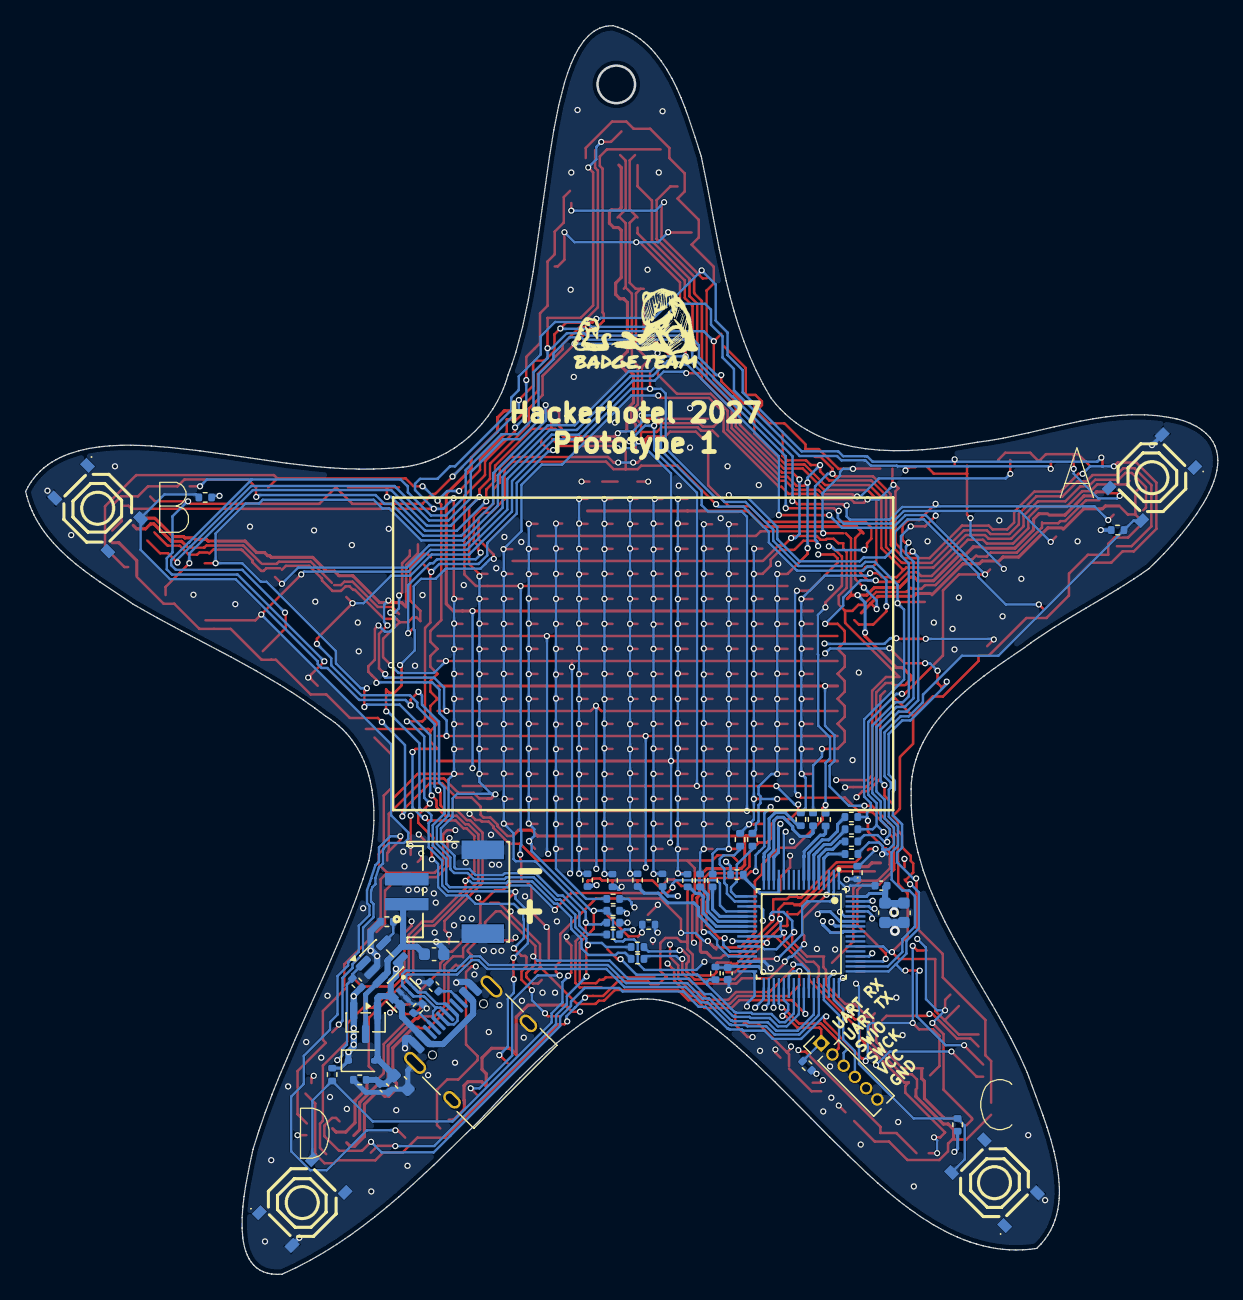
[picture p13: board hackerhotel2027.kicad_pcb from below]

Board: 6 copper layers, 95.4 x 99.9 mm, 373 parts (56 on the bottom side), 86 nets.
