badgeteam/hackerhotel2027-hardware/(commit log)

2026-09-27 Fill out all component LCSC numbers and fix footprint associations
    [display.kicad_sch, hackerhotel2027.kicad_pcb, hackerhotel2027.kicad_sch]
2026-09-28 Small tweaks & initial PCB work
    [hackerhotel2027.kicad_pcb, hackerhotel2027.kicad_sch]
2026-10-11 Switch to WCH ledmatrix controller, add loads of LEDs
    [bom.csv, bom_hh2027_1.csv, designators.csv, display.kicad_sch, hackerhotel2027.kicad_pcb, hackerhotel2027.kicad_sch, led_layout_test.kicad_pcb, positions.csv]
2026-10-11 More routing
    [hackerhotel2027.kicad_pcb]
2026-10-11 LED routing
    [hackerhotel2027.kicad_pcb]
2026-10-11 Add battery circuit, more routing
    [hackerhotel2027.kicad_pcb, hackerhotel2027.kicad_sch]
2026-10-12 More LED routing
    [hackerhotel2027.kicad_pcb]
2026-10-12 Add IR, add programming and UART headers, add buttons
    [bom.csv, designators.csv, hackerhotel2027.kicad_pcb, hackerhotel2027.kicad_sch, positions.csv]
2026-10-17 Move IR, more routing, different debug connector
    [hackerhotel2027.kicad_pcb, hackerhotel2027.kicad_sch]
2026-10-18 (temporarily) removed some LEDs, changed to 6 layer board, 0 unrouted, no DRC errors
    [hackerhotel2027.kicad_pcb, hackerhotel2027.kicad_sch]
2026-10-22 Basic routing done
    [hackerhotel2027.kicad_pcb]
2026-10-22 The final push (from me for prototype 1 :P)
    [bom.csv, designators.csv, hackerhotel2027.kicad_pcb, hackerhotel2027.kicad_sch, positions.csv]
2026-10-24 Some cleanup on the PCB.
    [hackerhotel2027.kicad_pcb, hackerhotel2027.kicad_sch]
2026-10-24 Prototype 1
    [bom.csv, designators.csv, hackerhotel2027.kicad_pcb, hackerhotel2027.kicad_sch, positions.csv]
2026-10-24 Prototype 1 (production)
    [bom.csv, designators.csv, hackerhotel2027.kicad_pcb, hackerhotel2027.kicad_sch, positions.csv]
2026-10-26 Different battery connector
    [bom.csv, hackerhotel2027.kicad_pcb, hackerhotel2027.kicad_sch, positions.csv]
2026-10-26 Move silkscreen hint for battery polarity
    [hackerhotel2027.kicad_pcb]
