badgeteam/hackerhotel2027-hardware/(notices)

Notices in the files:
hackerhotel2027.kicad_sch:
Copyright Stichting Badge.Team 2026
License: CERN-OHL-P
